DanielRam62/Smart-Water-Dispenser-Project/hardware_implementation/pcb_design/pcb_design 2.png

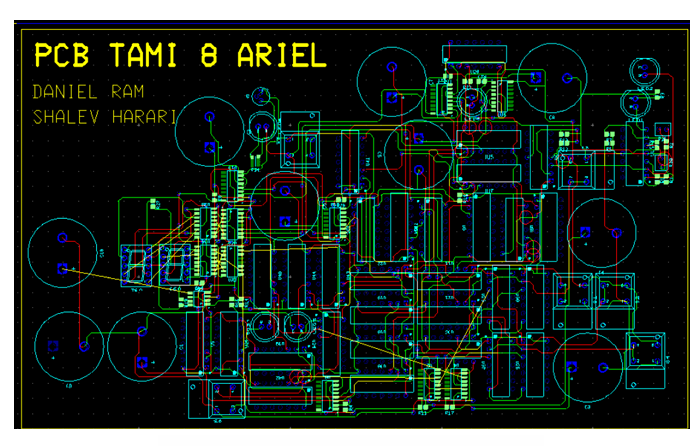
hardware_implementation/pcb_design/pcb_design 2.png
