DanielRam62/Smart-Water-Dispenser-Project/docs/project_summary.pdf

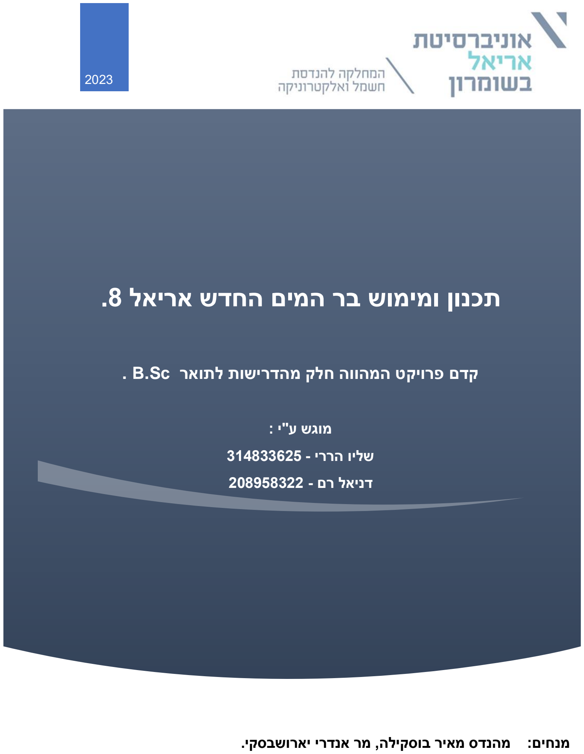
[picture p24: page 1]

# תכנון ומימוש בר המים החדש אריאל .8

קדם פרויקט המהווה חלק מהדרישות לתואר Sc.B .

### מוגש ע"י :

### שליו הררי - 314833625

### דניאל רם - 208958322

2023

מנחים: מהנדס מאיר בוסקילה, מר אנדרי יארושבסקי.

## תוכן העניינים:

.1.1 התפתחות ההיגיינה בעולם המודרני 4 |
.1.2 שילוב מערכות חכמות בהגיינה 5 |
.1.3 הצורך 5 |
.2 מטרת הפרויקט 6 |
.2.1 תנאי התכנון 6 |
.2.2 דרישות המערכת 7 |
.3 תיאור המערכת 8 |
.3.1 סכמת בלוקים 8 |
.4 תיכנון ומימוש חומרתי 11 |
.4.1 מימוש החומרה 11 |
.4.2 תיכנון החומרה | 11..
.5 מימוש המערכת 13 |
.5.1 סימולציות ותצוגות סקופ 13 |
.5.2 מימוש החומרה ע"י מיקרו בקר )ארדואינו(. 31 |
.5.3 PCB של המערכת | 32.
.6 תוצאות ואתגרים33 |

## הכרת תודה

לאורך הפרויקט היו מספר גורמים ואנשים אשר סייעו הן במחשבה הן בדיבור והן במעשה להצלחת הפרויקט.

על כן ברצוננו להודות ראשית לבורא עולם אשר מלווה אותנו בחיים בכלל ובמהלך הלימודים בפרט.

בנוסף תודה מיוחדת למשפחתנו האהובה אשר כל זה לא היה מתאפשר בלעדיה אשר מלווים אותנו לאורך לימודי התואר ותומכים בנו לכל אשר נפנה.

כמו כן , תודה אישית למנחים, מאיר בוסקילה ואנדריי יארושבסקי על הליווי במהלך הפרויקט.

## תקציר:

בפרויקט זה תוכננה ומומש ה מערכת חכמה לבקרה ושליטה על בר מים חכם.

לשם כך, ראשית נלמדו ונותחו הדרישות והפרמטרים בהם המערכת צריכה לעמוד.

מתוך כך תוכננה סכמת בלוקים ראשונית אשר באמצעותה תוכננה המערכת ברמת החיבורים והרכיבים .

קיימת דרישה של שליטה ובקרה על מספר פרמטרים: טמפרטורת מים, זמני מזיגה, עצירת מזיגה, הרתחה, איתות גלישת מים, הצגת טמפרטורת מים בזמן אמת והצגת זמני המזיגה )ספירה לאחור(. כחלק מדרישות אלו יש צורך לממש זאת במעגלים דיסקרטיים בלבד.

בכדי להעריך את טמפרטורת המים על פרמטר נעשה שימוש בחיישן מתאים להערכת הפרמטר וביצוע מניפולציות על נתון זה בכדי לקיים את כלל הדרישות.

לאחר תכנון סכמת בלוקים בוצע תכנון החומרה אשר נעשה בתכנון רכיבים וחיבורים בתוכנת סימולציה Multisim ובוצעו סימולציות לתקינות המעגל.

לאחר מכן, בוצע מימוש על גבי מטריצת חיבורים ובוצעו בדיקות תקינות המעגלים. בנוסף, נעשה תכנון PCB המוכן להדפסה עבור מעגלים אלו.

לאחר מכן, לטובת הצגת טמפרטורת מים בזמן אמת נעשה שימוש במיקרו בקר ) ארדואינו( אשר בעזרתו המערכת תוכל להציג למשתמש את טמפרטורת המים בזמן אמת .

במהלך כלל העבודה בפרויקט בוצעו תיעודיים למדידות ולקביעות שנעשו ובהתאם לכך בוצעו תיקונים לייעול המעגלים.

## 1( מבוא

עולם ההיגיינה הינו עולם בהתפתחות מתמדת.

התפתחות זו באה לידי ביטוי בטכנולוגיות שונות שמטרתם להפוך את אורך חיינו לבריא יותר .

בבר המים אריאל 8 בפרט קיימו ת דרישות רבות לייעול ובקרה על איכות המים. טמפרטורה, זמן מזיגה, קירור והרתחה ובנוסף אבטחה על המתקן .

השתלבות עולם ההנדסה בהתפתחות זו בא לידי ביטוי ביצור מערכות בקרה ושליטה על כלל הפרמטרים הנדרשים.

1.1 התפתחות ההיגיינה בעולם המודרני.

משחר ההיסטוריה היו מספר בעיות אשר גרמו לפגיעה בקדמה ש ל המין האנושי, כאשר השתיים המרכזיות הינן: חוסר היגיינה ואי קרבה למים זורמים.

מתחילת צעדיו של המין האנושי על פני כוכב לכת זה יכולנו לשים לב כי הדבר החיוני ביותר להתיישבות הינו מים זורמים ונקיים, אנו יכולים להבחין כי רוב אם לא כלל הערים העתיקות נבנו על יד מקורות מים נקיים אשר שימשו אותם בתחילה לשתייה ולחקלאות ובהמשך להפקת אנרגיה.

דבר נוסף אשר מאוד השפיע על המין האנושי היה חוסר בהיגיינה, נוכל לשים לב כי במהלך ההיסטוריה היו לא מעט מגפות, לדוגמא מגפת המוות השחור אשר הכתה באירופה במהלך המאה ה14 אשר קיפחו את חייהם של לא מעט אנשים, דבר אשר השפיע מאוד על הקדמה של המין האנושי.

עם התפתחות הטכנולוגיה והכרה במושג שנקרא היגיינה הומצאו פתרונות אשר בעזרתם המין האנושי יוכל להגדיל את תוחלת חייו ובנוסף להתגבר על מגפות אשר פוקדות את כוכב לכת זה, לדוגמא הקורונה, בעזרת שימוש רחב במוצרי היגיינה הצליח המין האנושי להתגבר על מג פה זו.

עם ההתפתחות, הטכנולוגיה שולבה גם בעולם ההיגיינה ובכך קידמה את האפשרות לתת למין האנושי אפשרות להתיישבות גם באזורים בהם לא ניתן להתקיים ממי השתייה )עקב זיהום נהרות ( ע"י פיתוח מוצר בר מים.

פיתוחים אלו הביאו לעלייה בתוחלת החיים ומתן נגישות של מים נקיים ליותר אוכלוסיות.

1.2 שילוב מערכות חכמות בהיג יינה.

עם התפתחות של העולם המודרני המערכת החיסונית של האדם נחלשה, אם בעבר אדם היה מצליח לחיות עד גיל מסוים ללא שימוש בחיסונים ובגישה מוגבלת למים נקיים בימינו דבר זה אינו אפשרי, כתוצאה מכך נדרש האדם לתת מענה לבעיה מספר אחת של האנושות, מקור מים זורמים ונקיים.

לשם כך נתכנסו כלל המהנדסים באוניברסיטת אריאל והבינו כי יש צורך למתן מכשיר ביתי אשר בעזרתו נקבל גישה למים נקיים ובנוסף אפשרות למתן מים רותחים וקרים אשר משמשים אותנו בצרכי היומיום. לשם כך קיימות מערכות טכנולוגיות לשליטה ובקרה על טמפרטורת המים. זמן מזיגה, זליגת מים מהכוס, מתן אפשרות להפסקת מזיגה ועוד.

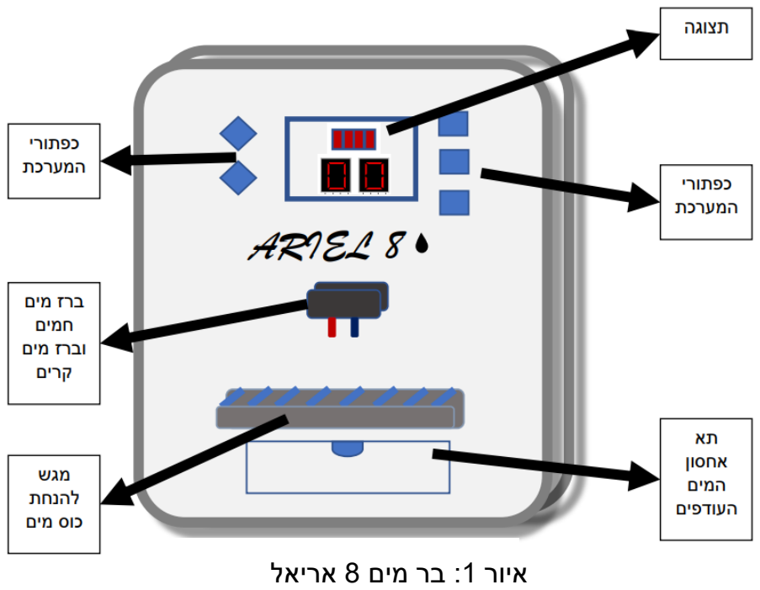
[picture p25: figure]

### 1.3 הצורך

עולם ההיגיינה מתפתח בצעדי ענק ומביא למהפכה בתחום, אך הבעיה העיקרית שהוא נלחם נגדה כיום הוא שינוי ההרגל של האדם הממוצע, בימנו לא מעט אנשים אינם שותים מספיק מים במהלך היום )במיוחד בימי החורף(, אחת מהדרכים להתמודד עם בעיה זו היא העלאת המודעות לחשיבות של צריכת מים נקיים ובנוסף לצריכת מים בכללי במהלך היום.

לשם כך הומצא בר מים זה אשר בעזרת לחיצת כפתור נותן גישה למקור מים נקיים ומרעננים בקלות ובמהירות.

איור :1 בר מים 8 אריאל | איור :1 בר מים 8 אריאל

## 2( מטרת הפרויקט

פיתוח מערכת אשר בעזרתה ניתן לתת הנגשה למים ראויים לשתייה לכל אחד מהבתים בישראל, מערכת זו נותנת אפשרות למשתמש לבחור את סוג המים )חמים , קרים ופושרים(, את זמן המזיגה של המים ) es ,4 es 8 ו es 15 ( ובנוסף מאותת למשתמש על מצב זליגה של מים מכלי המילוי.

2.1 תנאי התכנון.

בר המים שתוכנן במסגרת הקורס יכלול:

.1 בקר השולט על טמפרטורת המים 90° − .50° .2 בקר שני השולט על טמפרטורת המים 10° − .5° .3 כפתור הרתחה ל- .90°
.4 אפשרויות זמני מזיגה שונות. .5 מד טמפרטורה המציג את טמפרטורת המים בזמן אמת. .6 אפשרות הפסקת מזיגה בכל רגע נתון. .7 מתן איתות למשתמש כאשר מתבצעת זליגת מים מהכוס. .8 ספירה לאחור בעת מזיגת המים.

2.2 דרישות המערכת.

.1 בחירת סוג מים - על המערכת לתת למשתמש אפשרות לבחור את סוג המים בו הוא חפץ, חמים קרים או פושרים.

.2 הטמפרטורה שהבקר שולט עליה מתחלקת לשני חלקים. 2.1 -מים חמים- על הבקר לשמור על טווח טמפרטורת המים בין 90° − .50° 2.2 -מים קרים- על הבקר לשמור על טווח טמפרטורת המים בין 10° − .5°

.3 מספר אפשרויות המזיגה מתחלקת לשלושה חלקים: 3.1 : מים חמים - על המערכת לתת אפשרות מזיגת מים בתנאי והטמפרטורה של המים החמים מעל 90° למשך es .4 3.2 : מים קרים - על המערכת לתת אפשרות מזיגת מים כאשר זמני המזיגה הם כדלקמן : es ,4 es 8 ו es .15 בטווח טמפרטורה של 10° − .5° :3.3 מים פושרים - על המערכת לתת אפשרות מזיגת מים בטווח הטמפרטורה של 35° − 25° למשך es .4

.4 הרתחה- למשתמש ישנה אפשרות להרתיח את המים עד לטמפרטורה של .90°

.5 מד טמפרטורה- לכל אורך זמן המזיגה על המערכת להציג למשתמש את טמפרטורת המים ואת זמן המזיגה הנותר לסיום מילוי הכוס.

.6 אפשרות הפסקת מזיגה- על המער כת לתת אפשרות למשתמש לבצע הפסקת מזיגה בכל רגע נתון ע"י לחיצה על אחד מלחצני המערכת.

.7 מתן איתות- על המערכת לאותת למשתמש כי מתחילה זליגה של מים מ תא אחסון המים.

.8 ספירה לאחור – על המערכת להציג את זמן מזיגת המים שנותר בשעת מזיגה .

3( תיאור המערכת.

3.1 הסבר כללי על המערכת - סכמת בלוקים.

.1 שליטה על הטמפרטורה.

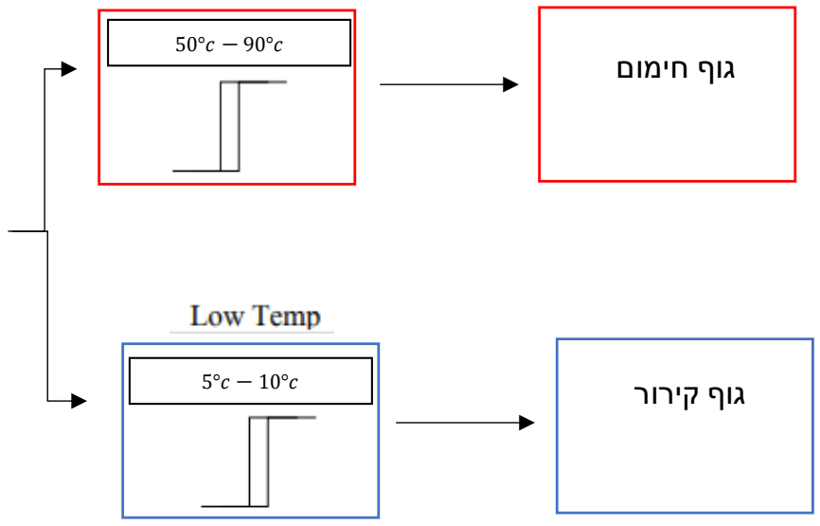
[picture p26: figure]
גוף חימום; גוף קירור

.2 מצב הרתחת מים.

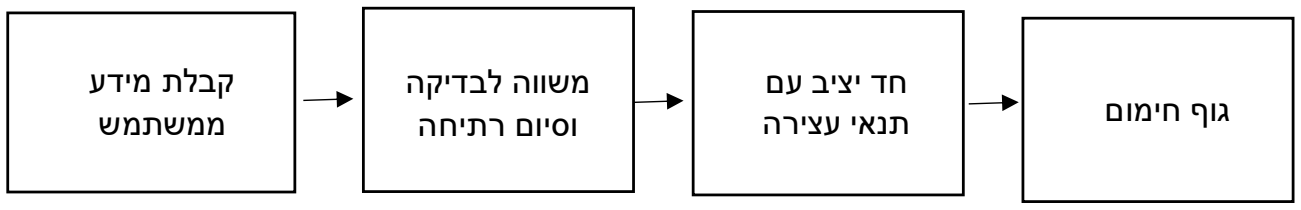
[picture p27: figure]
משווה לבדיקה וסיום רתיחה; קבלת מידע ממשתמש; חד יציב עם גוף חימום תנאי עצירה

.3 מצב מזיגת מים חמים

חיישן
טמפרטורה

איור :2 סכמת בלוקים לשליטה על טמפרטורה.

איור :3 סכמת בלוקים להרתחה המים

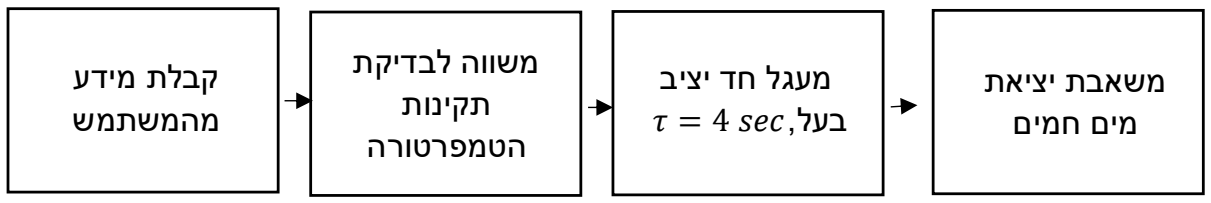
[picture p28: figure]
משווה לבדיקת תקינות הטמפרטורה; קבלת מידע מהמשתמש; מעגל חד יציב בעל,es 4 = ; משאבת יציאת מים חמים

איור :4 סכמת בלוקים למזיגת מים חמים.

4 . מצב מזיגת מים קרים.

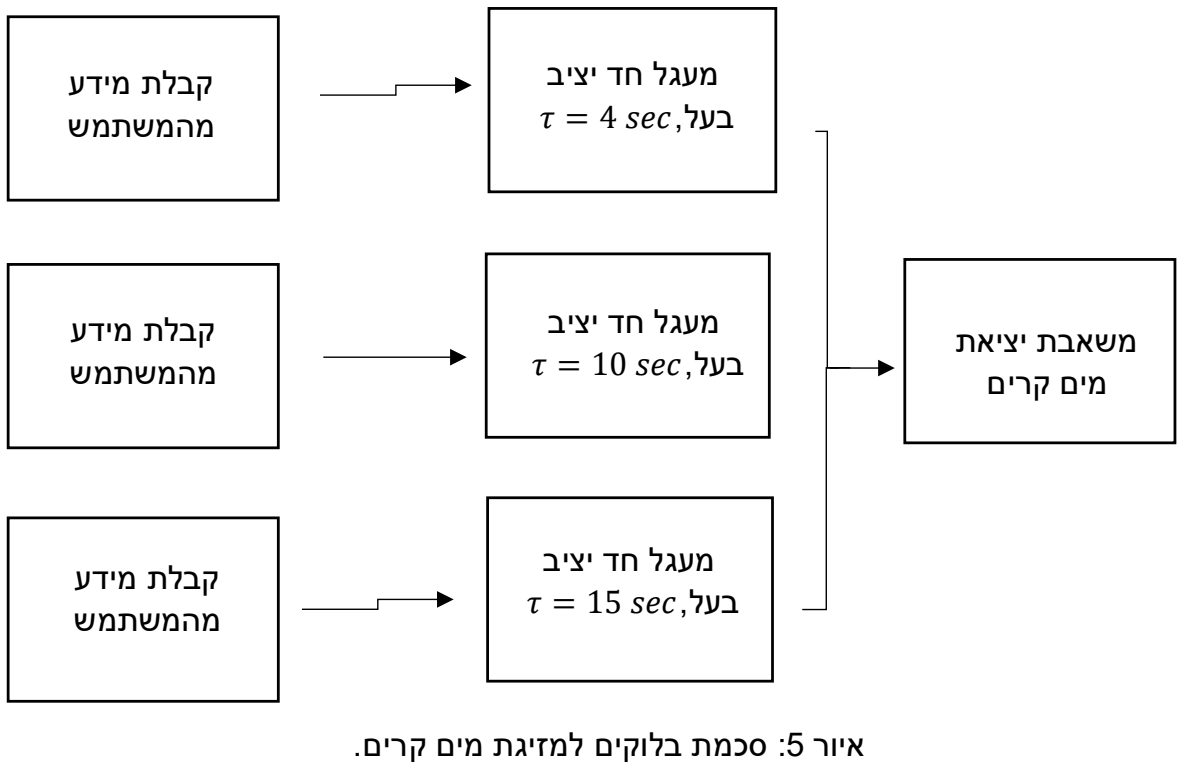
[picture p29: figure]
קבלת מידע מהמשתמש; מעגל חד יציב בעל,es 4 = ; מעגל חד יציב בעל,es 10 = ; מעגל חד יציב בעל,es 15 = ; משאבת יציאת מים קרים; איור :5 סכמת בלוקים למזיגת מים קרים.

5 . מצב מזיגת מים פושרים.

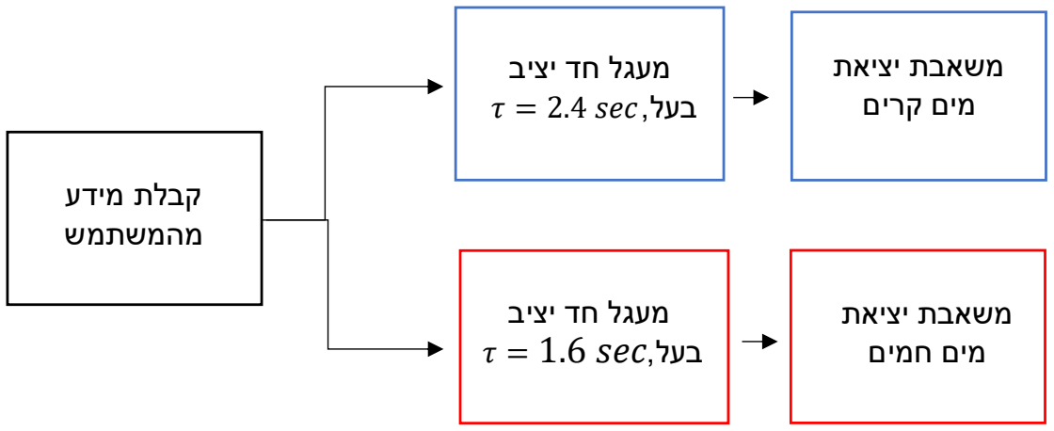
[picture p30: figure]
קבלת מידע מהמשתמש; משאבת יציאת מים קרים; משאבת יציאת מים חמים; מעגל חד יציב בעל,es 2.4 = ; מעגל חד יציב בעל,es 1.6 = 

איור :6 סכמת בלוקים למזיגת מים פושרים.

6 . צג ספירה לאחור

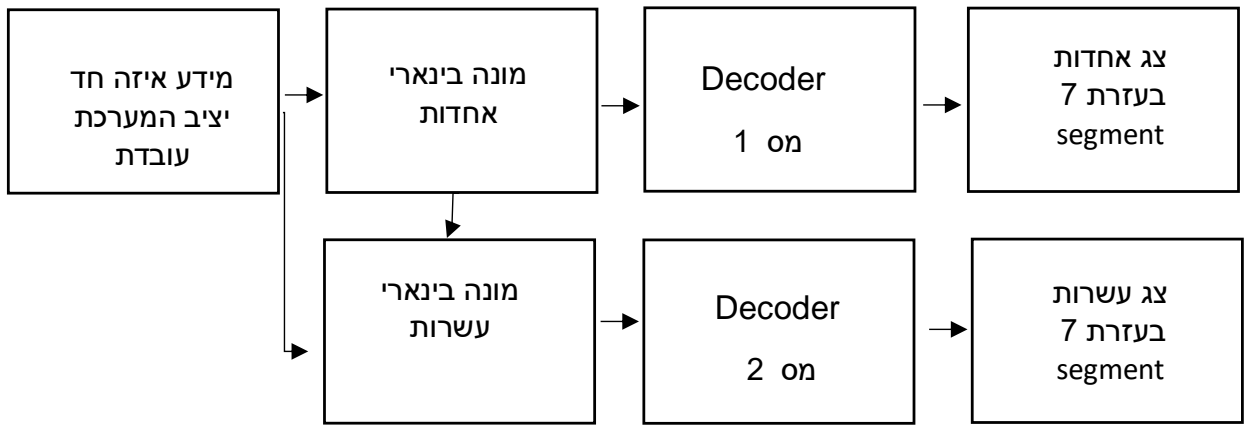
[picture p31: figure]
מידע איזה חד יציב המערכת עובדת; מונה בינארי אחדות; מונה בינארי עשרות; Decoder; צג אחדות בעזרת 7 segment; צג עשרות בעזרת 7 segment

7 . עצירת מערכת בעת לחיצה בזמן מזיגה .

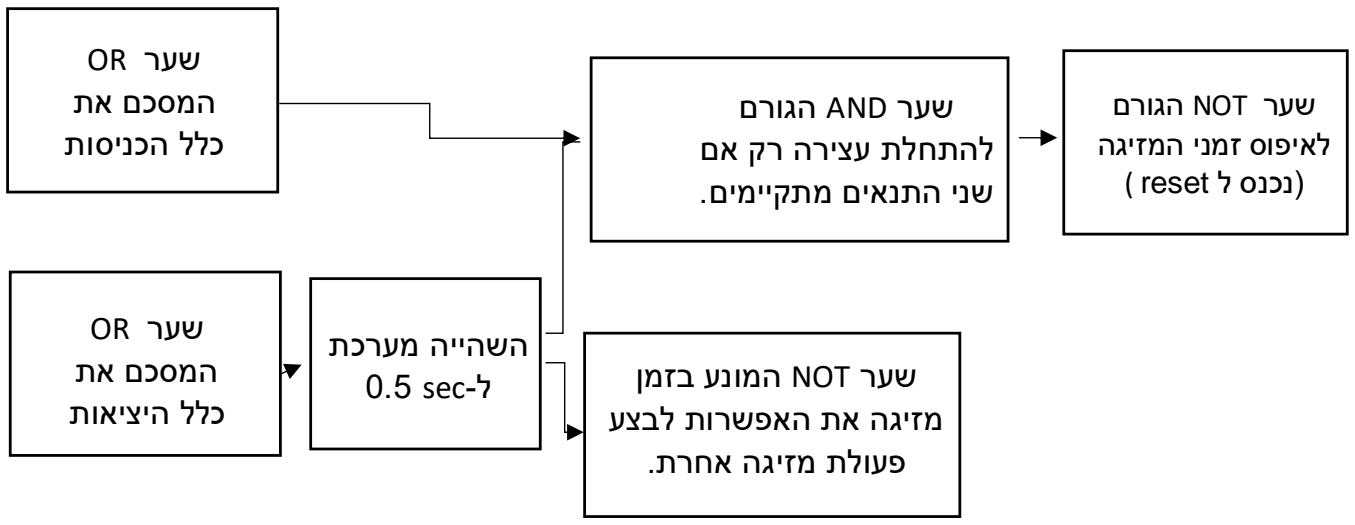
[picture p32: figure]
שער OR המסכם את כלל הכניסות; שער AND הגורם להתחלת עצירה רק אם שני התנאים מתקיימים.; שער OR המסכם את כלל היציאות; שער NOT הגורם לאיפוס זמני המזיגה )נכנס ל reset(; שער NOT המונע בזמן מזיגה את האפשרות לבצע פעולת מזיגה אחרת.; השהייה מערכת ל-sec 0.5

8 . נורת אזהרה.

איור :7 סכמת בלוקים להצגת ספירה לאחור.

איור :8 סכמת בלוקים להצגת עצירת מערכת.

חוט חשוף המחובר
לסף המים

חוט חשוף המחובר
ל-VCC

טרנזיסטור BJT
משמש בתור
מתג.

LED אינדיקציה,
המאותת
למשתמש

איור :9 סכמת בלוקים לנורת אזהרה.

4( תיכנון ומימוש חומרתי.

4.1 מימוש החומרה.

אופן המימוש בוצע על גבי מטריצת חיבורים אשר עליה נבנו כלל המעגלים על ידי הרכיבים הבאים

.1 מימוש בקר מים קרים , רכיבים - נגדים, מגבר )071TL(, חיישן טמפרטורה.
.2 מימוש בקר מים חמים, רכיבים- נגדים, מגבר (071TL( (מימוש שמידט טריגר(, חיישן טמפרטורה.
.3 כפתור הרתחת מים חמים, רכיבים- נגדים, קבלים, מעגל חד יציב )14538CD),
.)AND, OR, NOT( | לוגים | שערים | ,(TL071( | מגבר
.4 כפתור לחיצה המאפשר מזיגת מים חמים, רכיבים- נגדים, קבלים, מעגל חד יציב
.(AND,OR( | לוגים | שערים | ,(MC14538(
.5 כפתור לחיצה המאפשר מזיגת מים קרים ע"פ בחירת משתמש, רכיבים - נגדים, קבלים, חד יציב ) 14538MC )שערים לוגים )OR,AND(. .6 כפתור לחיצה המאפשר מזיגת מים פושרים, רכיבים- נגדים, קבלים, חד יציב )14538MC), שער לוגי Or.
.7 ספירה לאחור, רכיבים – segment seven, Decoder) D47LS74 (, נגדים, שערים
.)74LS190D( | בינארי | מונה | ,(Or And ( | לוגים
.8 מד טמפרטורה, רכיבים – מיקרו בקר )ארדואינו(, חיישן טמפרטורה.

כמו כן המטריצה הוזנה לאספקת מתח קבוע של V5 להספקת כלל הרכיבים במעגל.

4.2 תכנון החומרה.

טמפרטורה – חיישן הטמפרטורה הינו נגד משתנה כתלות בטמפרטורה. עבור תחומי הטמפרטורה הרצויים הובאו ערכי התנגדות החיישן מתוך דפי הנתונים כדלהלן :

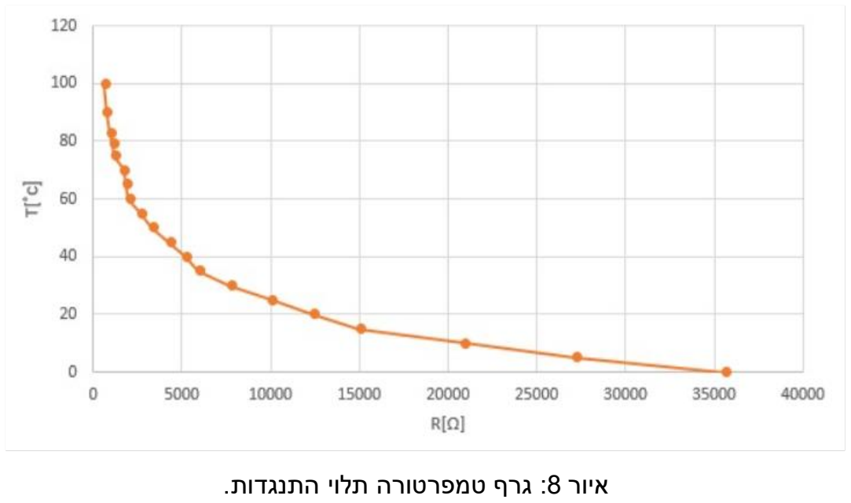
[picture p33: figure]
Ϲ מעלות; התנגדות )Ω); גרף התנגדות חיישן טמפרטורה; איור :8 גרף טמפרטורה תלוי התנגדות.

באיור 8 נוכל להבחין בגרף המתאר את טמפרטורת החיישן כתלות בהתנגדות, בעזרת גרף זה ניתן לחשב את יחס הנגדים הנדרש בכדי לאותת למערכת כי טמפרטורת המים תקינה.

טבלה 1 – ערכי התנגדות החיישן ומתח בטמפרטורות נצרכות

| | טמפרטורה ]˚C ]התנגדות ]kΩ ]מתח מוצא חיישן ]V ]
1.62 | 20.8 | 10
3.75 | 3.3 | 50
4.66 | 0.725 | 90

בתחילה חובר החיישן טמפרטורה לרב מודד כאשר בכל פעם הועלתה הטמפרטורה ונמדדה התנגדותו, לאחר מכן נעשה חישוב הבא בעזרת נוסחת מחלק מתח:

(1) Vout,sensor = VCC ∗

10k

10k + Rsensor

[V]

ובכך התקבל כי לכל התנגדות מתקבל מתח מוצא שונה אשר בעזרתו נוכל להבין מתי בקר הרתחה אמור להתחיל ולסיים את עבודתו , וכמו כן האם מזיגת מים חמים יכולה להתאפשר.

מים פושרים- על המערכת לתת אפשרות מזיגת מים בטווח הטמפרטורה של 35° − 25° למשך es .4 לשם כך תוכנן יחס המים על ידי ניסוי וטעייה, ונמצא:

טבלה 2 – תיכנון מזיגת המים הפושרים

אכן נמצא שיחס המים לעיל עומד בדרישות המערכת והוא נבחר כיחס הנגדים האחראים על זמן מזיגת המים הפושרים.

טמפרטורה סופית ]˚c[ | יחס מים של מזיגת המים | טמפרטורה חמים ]˚c[ | טמפרטורה קרים ]˚c[
27 | 3/5 | 51 | 7
34 | 2/5 | 85 | 7

5( מימוש המערכת.

5.1 סימולציות ותצוגות סקופ.

.1 תכנון מפורט ברמת החיבורים של בלוק טמפרטורה עבור מים קרים.

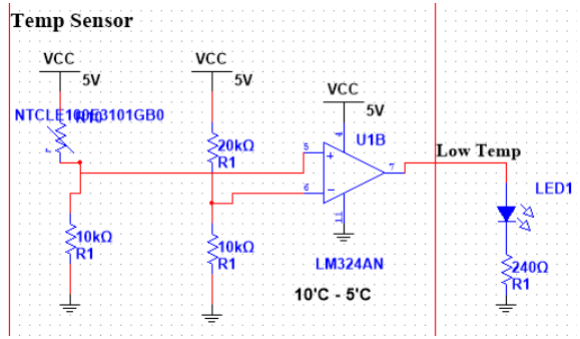
[picture p34: figure]

סנסור הטמפרטורה הינו נגד משתנה כפונקציה של הטמפרטורה והוא מזין את רגל החיובית של המגבר .

באיור מספר 9 ניתן להבחין במגבר משווה, אשר תפקידו לייצר מעגל חשל טמפרטורה עבור טמפרטורה נמוכה וזאת בעזרת השוואה בין המתחים כאשר המתח הנמצא ברגל המינוס של המגבר הוא קבוע )המסמן הגעה ל 10° ראה טבלה 1(.

תוכנן כך כאשר מתח רגל הפלוס של המגבר יותר גדול ממתח רגל המינוס של המגבר הלד יידלק )המסמן שהטמפרטורה גבוהה מ 10°) וכך יסמן למערכת לקרר את המים בחזרה למתחת ל.10°

בנוסף ניתן לשים לב כי במעגל זה יש LED אשר תפקידו לאותת למשתמש כי הבקר עובד, מתחיל תהליך קירור של המים.

איור :9 סימולציה עבור בקר מים קרים.

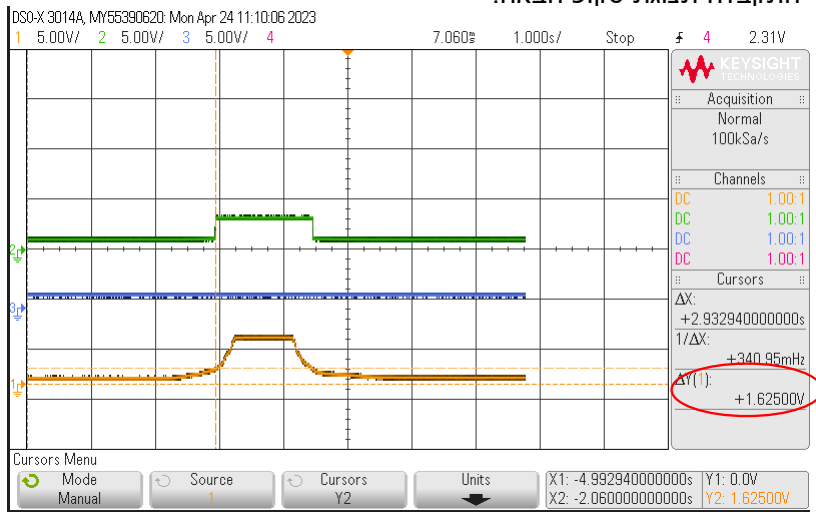
[picture p35: figure]

בהמשך התקבלה תצוגת סקופ הבאה:

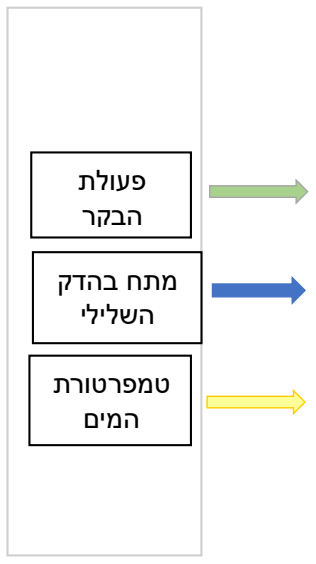
[picture p36: figure]
טמפרטורת המים; פעולת הבקר; מתח בהדק השלילי

תחילה הורכב המעגל באיור 9 )בקר מים קרים(, באיור 10 ניתן להבחין בשלושה ערוצים.

ניתן להבחין בשלושה דברים עיקריים :

הראשון - טמפרטורת החיישן )צהוב(, ניתן לשים לב כי כאשר הטמפרטורה גבוהה מ 10° המסמן הגעה של מתח של V1.625( הסבר בטבלה 1( מתקבל פולס )ירוק ( להתחלת קירור המים הקרים.

השני - פולס שהבקר מוציא להתחלת קירור המים, כפי שהוסבר בתחילה ניתן להבחין כי כל עוד מתח בהדק החיובי של המגבר המסמן את טמפרטורת המים גבוהה ממתח ההדק השלילי המסמן טמפרטורה של 10° מתחילה פעולת הבקר )ירוק( .

השלישי-מתח בהדק השלילי של המגבר המסמן הגעה לטמפרטורה של 10° )כחול (.

איור :10 סקופ בקרת מים קרים.

2 . תכנון מפורט ברמת החיבורים של בלוק טמפרטורה עבור מים חמים.

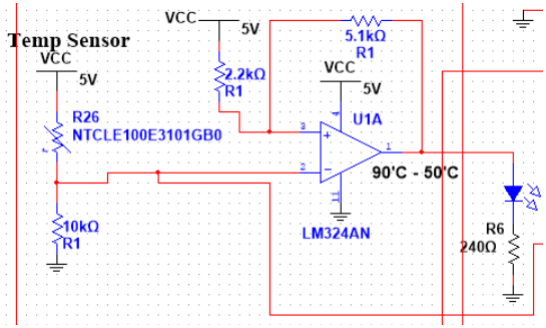
[picture p37: figure]

סנסור הטמפרטורה הינו נגד משתנה כפונקציה של הטמפרטורה והוא מזין את רגל השלילית של המגבר .

באיור מספר 11 ניתן להבחין במגבר הממומש בתצורה של "שמידט טריגר" אשר בעזרתו המערכת תוכל להבחין מתי הטמפרטורה יורדת מתחת ל 50° וכך תדליק את הלד המסמן למערכת להתחיל את תהליך הרתחה.

בנוסף ניתן לשים לב כי במעגל זה יש LED אשר תפקידו לאותת למשתמש כי הבקר עובד, מתחיל תהליך ההרתחה של המים.

איור :11 סימולציה עבור בקר מים חמים.

בהמשך התקבלה תצוגת סקופ הבאה:

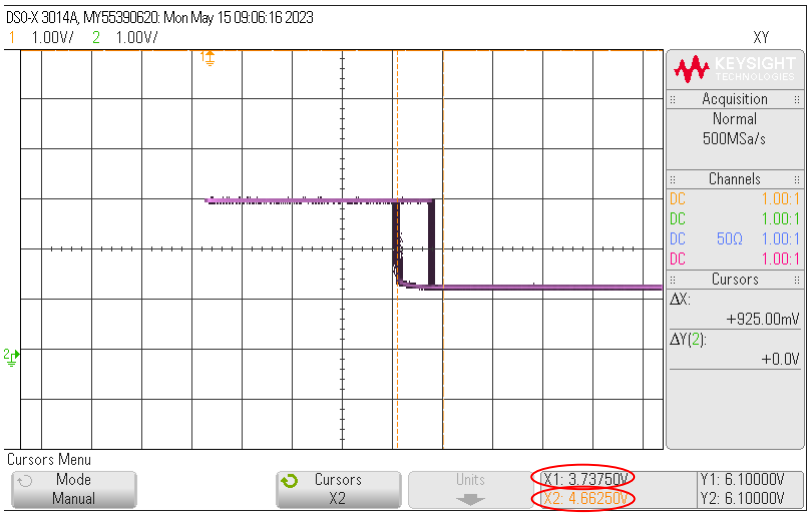
[picture p38: figure]

תחילה הורכב המעגל באיור 11 )בקר מים חמים(, באיור 12 ניתן להבחין בתצורת המעגל במישור XY.

בנוסף ניתן להבחין בשלושה דברים עיקריים:

הראשון - תצורת האות במישור XY, נוכל להבחין בתצוגה המזכירה עקומת חשל, כאשר ניתן לראות בברור מתי הבקר מתחיל לעבוד ומתי הינו בהפסקה.

השני - ערך ה "Cross של 2X", ניתן לשים לב כי ה Cross מצביע על מתח של V,4.66 כאשר מתח זה הינו מתח הסף המצביע על 90° )ראה טבלה 1(.

השלישי- ערך ה "Cross של 1X", ניתן לשים לב כי ה Cross מצביע על מתח של V,3.73 כאשר מתח זה הינו מתח הסף המצביע על 50° )ראה טבלה 1(.

ניתן לראות כי אכן נשמרת טווח הטמפרטורה הרצוי.

איור :12 סקופ בקרת מים חמים.

.3 תכנון מפורט ברמת החיבורים של בלוק ההרתחה.


באיור מס 13 ניתן להבחין במספר רכיבים אשר תפקידם לבצע את פעולת הרתיחה. הראשון מגבר – תפקידו לבדוק האם הטמפרטורה נמצאת מתחת ל- 90° וכך לבצע הרתחה של המים ובנוסף להפסיק את פעולת ההרתחה כאשר טמפרטורת המים מגיעה ל-.90°c

השני שעון- השעון עצמו לא נמצא בסימולציה אך תפקידו נראה בברור, שעון זה אחראי על איתות הנורה, כאשר אות השעון נכנס לשער AND עם הפולס שיוצא מהחד יציב מתקבל מצב של הבהוב אשר מאותת למשתמש כי המערכת נמצאת במצב הרתחה.

השלישי מעגל חד יציב- תפקידו של רכיב זה הוא להפעיל את בקר ההרתחה כאשר הנחה היא שתוך sec20 המערכת "מצליחה" להרתיח את המים לטמפרטורה של .90°

איור :13 סימולציה עבור הרתחת המים החמים.

בהמשך התקבלה תצוגת סקופ הבאה:

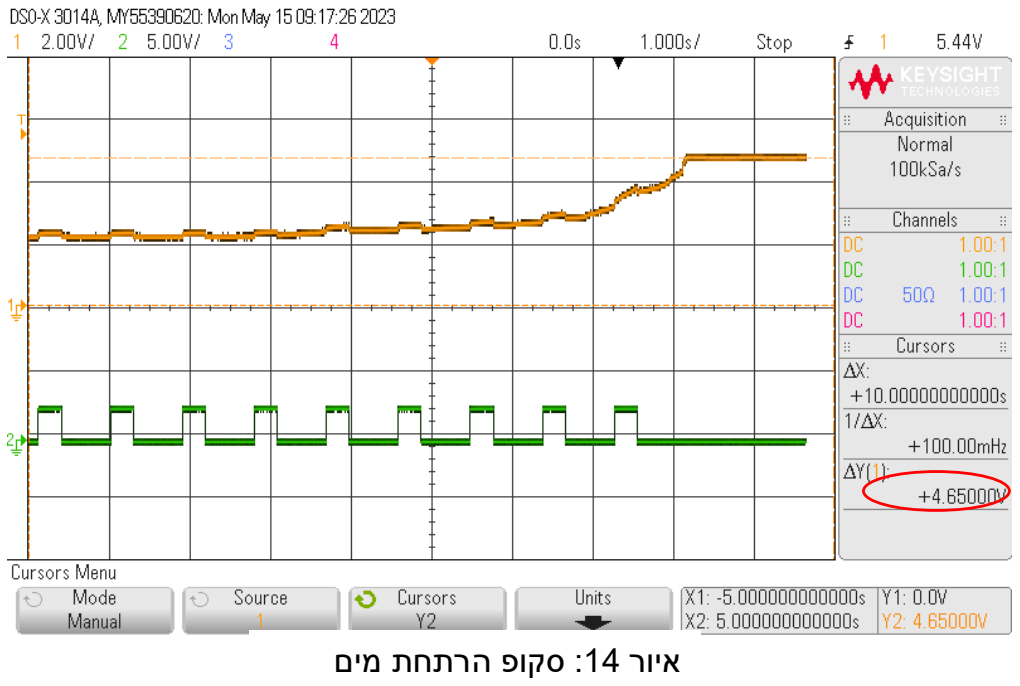
[picture p39: figure]
איור :14 סקופ הרתחת מים

באיור מספר 14 נוכל להבחין בשני ערוצים:

הראשון )צהוב( מראה את פעולת הבקר, השני )ירוק( מראה את הבהוב הנורה.

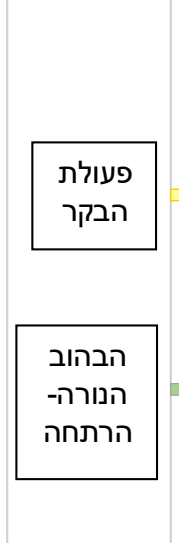
[picture p40: figure]
פעולת הבקר; הבהוב הנורה- הרתחה

נוכל לשים לב כי בתחילה מתקבל גל ריבועי המסמן את פעולת ההבהוב של הלד)ירוק(, ככל שטמפרטורת המים עולה כך יורדת ההתנגדות של החיישן, וכתוצאה מכך עולה המתח של הבקר עד אשר הוא מגיע למתח של V4.65 המסמן הגעה ל 90° )צהוב(, כאשר הבקר מגיע לטמפרטורה זו ניתן להבחין בהפסקת הפולסים המסמן כי ברגע זה נגמרת פעולת ההבהוב של הנורה המאותת למשתמש כי המים ראויים לשימוש.

.4 תכנון מפורט ברמת החיבורים של מזיגת מים חמים.

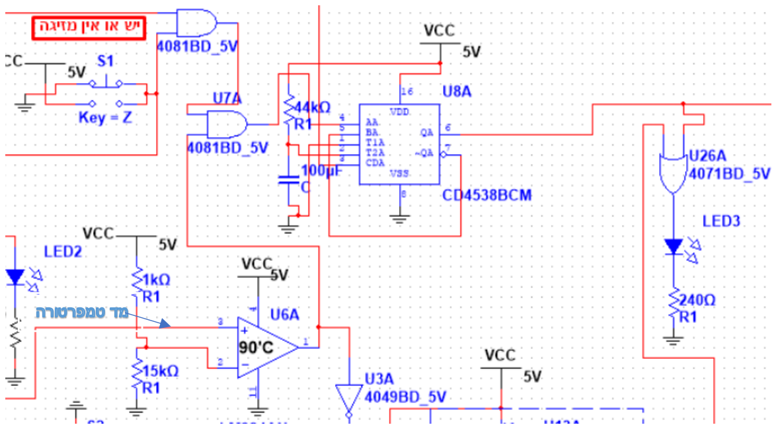
[picture p41: figure]

באיור מס 15 נוכל להבחין במספר רכיבים שבעזרתם נוכל לבצע את פעולת המזיגה כראוי.

הראשון מתג – תפקידו לתת למערכת אינדיקציה כי המשתמש מעוניין להתחיל את תהליך המזיגה.

השני מגבר- תפקידו לתת אינדיקציה למערכת האם טמפרטורת המים מעל ל,90°

האות מהמגבר וגם האות מהמשתמש נכנסים לתוך שער AND אשר תפקידו לתת אינדיקציה כי שני התנאים למזיגה מתקיימים וכך מתחילת פעולת המזיגה.

השלישי מעגל חד יציב – תפקידו של רכיב זה הוא לבצע את פעולת זמן המזיגה, זמן המזיגה מומש בעזרת הנוסחה הבאה:

(2) τ = RC[sec]

לשם כך נבחרו הקבל והנגד הנ"ל למימוש הדרישה.

איור :15 סימולציה עבור מזיגת מים חמים.

בהמשך התקבלה תצוגת סקופ הבאה:

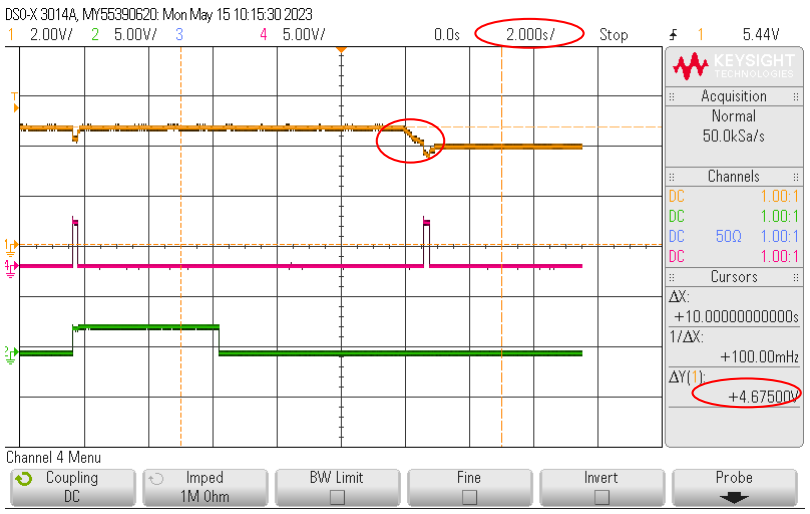
[picture p42: figure]

באיור מספר 16 נוכל להבחין בשלושה ערוצים:

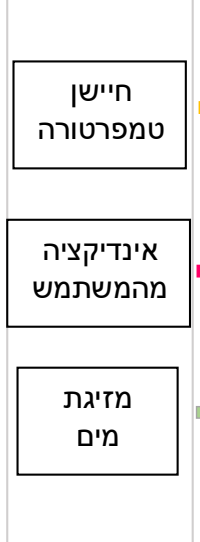
[picture p43: figure]
חיישן טמפרטורה; אינדיקציה מהמשתמש; מזיגת מים

הראשון )כתום( מראה את טמפרטורה המים , השני )ורוד( מראה את המידע שהמשתמש מזין למערכת, השלישי ) ירוק( מראה את מזיגת המים החמים.

בערוץ הראשון )כתום( – ניתן להשים לב למתח, ככל שטמפרטורת המים עולה ישנה ירידה בהתנגדות של החיישן, כתוצאה מכך עולה המתח של החיישן. במקרה הנ"ל מתח החיישן מתחיל מעל לV4.65 המסמן טמפרטורה מעל 90° ולאחר זמן מתח החיישן יורד מתחת לV4.65 המסמן ירידה של טמפרטורה למתחת ל- .90°

בערוץ השני )ורוד ( – נוכל להבחין בשני "הלמים", הלמים אלו נוצרים מבחירתו של משתמש )מתקבלת לחיצה על המתג(. ישנם שני הלמים בתצוגה זו, כאשר הראשון מצליח לגרום לפעולת מזיגה בעוד השני אינו מצליח, הבדל זה נובע מכך שטמפרטורת המים מתחת למתח של V,4.65 בעוד שניתן להבחין כי במקרה הראשון מתח החיישן מעל ל V4.65 המסמן שטמפרטורת המים מעל 90° כתוצאה מכך נשים לב כי לא התחילה פעולת מזיגה בשנית עקב שינוי בטמפרטורה.

בערוץ השלישי )ירוק( – נוכל להבחין בפעולת המזיגה, נוכל לשים לב שכל ריבוע בתצוגה מייצג es 2 וכי רוחבו של הפולס המתקבל הוא לערך שני ריבועים דבר המצביע על תקינות זמן המזיגה.

איור :16 סקופ מזיגת מים חמים.

5 . תכנון מפורט ברמת החיבורים של בלוק מזיגת מים קרים.


באיור מספר 17 נוכל להבחין במספר רכיבים אשר בעזרתם נוכל לבצע את פעולת המזיגה.

הראשון מתגים- תפקידים של מתגים אלו הוא לתת אינדיקציה למערכת להתחיל את פעולת המזיגה אשר המשתמש חפץ.

השני מעגלי חד יציב – בסימולציה זו ישנם שלושה מעגלים אך תפקידם זהה, תפקידו של כל מעגל הינו לשלוח פולס לאורך זמן מסוים בכדי לבצע את פעולת המזיגה, ערכי הקבלים

איור :17 מעגל עבור מזיגת מים קרים.

והנגדים חושבו ע"פ משוואה 2 כאשר בכל פעם נדרש מהמערכת להוציא פולס באורך זמן אחר , כאשר הזמנים הינם es 4 ,es 8 ,es 15 בהתאמה.

בהמשך התקבלה תצוגת סקופ הבאה:

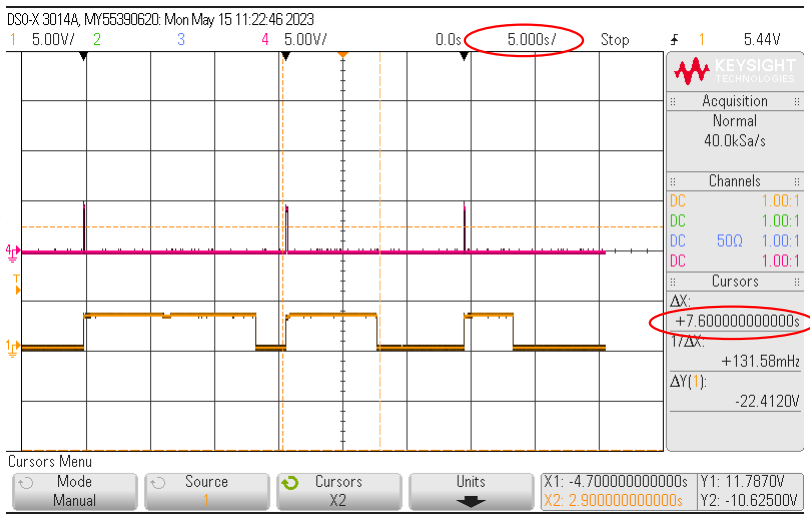
[picture p44: figure]

באיור מספר 18 נוכל להבחין בשני ערוצים:

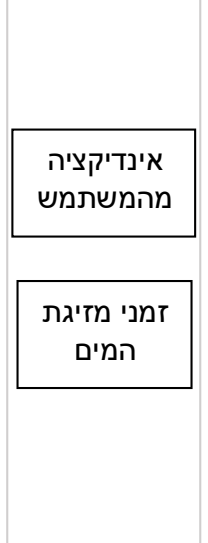
[picture p45: figure]
אינדיקציה מהמשתמש; זמני מזיגת המים

הראשון )ורוד( מראה את המידע שהמשתמש מזין למערכת, השני )צהוב( מראה את זמן יציאת המים הקרים.

בערוץ הראשון )ורוד( – ניתן להבחין בשלושה "הלמים", הלמים אלו נוצרים מבחירתו של משתמש )מתקבלת לחיצה על המתג(. ישנם שלושה הלמים בתצוגה זו, כאשר כל אחד מהם מציג את תחילת פעולת המזיגה.

בערוץ השני )צהוב( – ניתן להבחין בפעולת המזיגה, נוכל לשים לב שרוחבו של כל ריבוע בתצוגה מייצג es .5 בכל פעם נוכל להבחין באורך פולס אחר, דבר זה נובע מהמידע שהמשתמש מזין למערכת, בתחילה ניתן להבחין באורך פולס המשתרע על בערך 3 משבצות אשר מייצג את זמן המזיגה שהינו es ,15 בהמשך ישנו פולס המשתרע על בערך משבצת וחצי אשר מייצג זמן המזיגה שהינו es ,8 לבסוף ישנו פולס המשתרע על כמעט משבצת אחת אשר מייצג זמן מזיגה שהינו es .4

איור :18 סקופ מזיגת מים קרים.

.6 תכנון מפורט ברמת החיבורים של בלוק מזיגת מים פושרים.

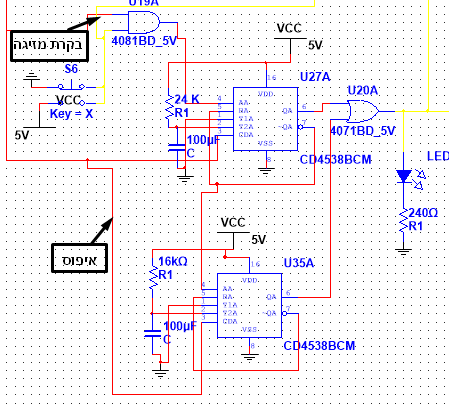
[picture p46: figure]

באיור מספר 19 ניתן להבחין במספר רכיבים אשר בעזרתם ניתן לבצע את פעולת המזיגה.

הראשון מתג – מתן אינדי קציה למערכת כי משתמש מעוניין במזיגת מים פושרים.

השני מעגלי חד יציב – תפקידם של שני מעגלים הוא להתחיל את תהליך המזיגה, כאשר המעגל החד יציב הראשון מחובר למשאבה של המים הקרים , והמעגל של החד יציב השני מחובר למשאבה של המים חמים.

ערכי הנגדים והקבלים חושבו ע"י שני התנאים הבאים:

1( ע"י נוסחה 2 כאשר זמן המזיגה הכולל הינו es 4 . 2( יחס מזיגת המים כבטבלה 2 והוא 2/5 מזיגת מים חמים ו 3/5 מזיגת מים קרים כך שיתקבל הדרישה לטמפרטורה מים פושרים.

כתוצאה מכך זמן המזיגה של המים החמים נבחר כ- es 1.6 וזמן מזיגת המים הפושרים נבחר כ-es .2.4

איור :19 מעגל עבור מזיגת מים פושרים.

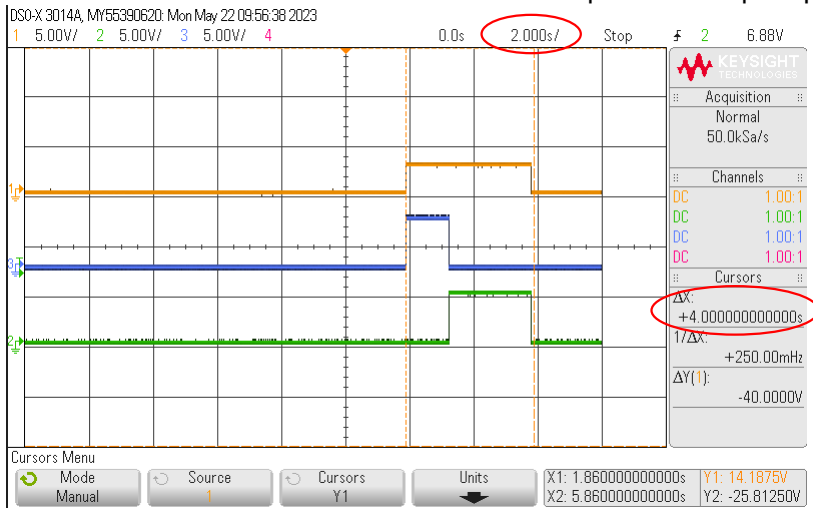
[picture p47: figure]

בהמשך התקבלה תצוגת סקופ הבאה:

באיור מספר 20 נוכל להבחין בשלושה ערוצים:

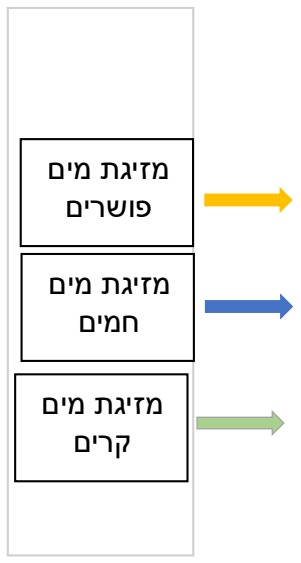
[picture p48: figure]
מזיגת מים פושרים; מזיגת מים חמים; מזיגת מים קרים

הראשון )צהוב( מראה את זמן המזיגה הכולל הנותן מים פושרים, השני )כחול( מראה את זמן יציאת המים החמים והשלישי )ירוק( מראה את זמן יציאת המים הקרים.

בערוץ הראשון )צהוב( – ניתן להבחין בפולס היציאה הכולל, זאת אומרת ניתן לשים לב לזמן הכולל של יציאת המים הפושרים, בנוסף ניתן להבחין בשני "קרוסים" המעידים על זמן מזיגה כולל של es 4 כפי שנדרש.

בערוץ השני )כחול( – ניתן להבחין בפעולת המזיגה של המים החמים, בנוסף ניתן להבחין באיור כי הזמן למשבצת הינו es 2 , הפולס הכחול הינו כמעט משבצת דבר המעיד על זמן מזיגה של מים חמים כ- es ,1.6 כפי שהיה ניתן לצפות.

בערוץ השלישי )ירוק( – ניתן להבחין בפעולת המזיגה של המים הקרים, בנוסף ניתן להבחין באיור כי הזמן למשבצת הינו es 2 , הפולס הירוק הינו משבצת וקצת דבר המעיד על זמן מזיגה של מים קרים כ- es ,2.4 כפי שהיה ניתן לצפות.

איור :20 סקופ מזיגת מים פושרים.

7 . תכנון מפורט ברמת החיבורים של עצירת מערכת.


באיור מספר 21 ניתן להבחין במספר רכיבים אשר בעזרתם ניתן לבצע את פעולת עצירת המערכת .

הראשון שערי OR - ניתן להבחין בשני שערי OR אשר לכל אחד מהם תפקיד שונה, הראשון – בזמן לחיצה, תפקידו של שער זה הוא לאגד את כלל הפולסים היוצאים מהמתגים בעת הלחיצה. השני – זמן מזיגה, תפקידו של שער זה הוא לאגד את כלל הפולסים היוצאים מכלל מעגלי החד יציב בזמן מזיגה.

השני שער AND - תפקידו של שער זה הינו לבצע בדיקה, בבדיקה זו השער יברר אם מתקבל מצב בו ישנו פולס מזיגה )מתבצעת מזיגת מים( ובנוסף ישנו פולס לחיצה )מתקבל מידע ממשתמש כי הוא מעוניין לעצור את מזיגת המים( אם ורק אם שני התנאים הללו מתקיימים שער זה יוציא " 1" לוגי.

השלישי שער )איפוס( NOT - תפקידו של שער זה הוא לבצע היפוך, כאשר יצא " 1" לוגי מהשער AND( זאת אומרת שני התנאים מתקיימים: מזיגה, מידע ממשתמש( נקבל היפוך של "1" לוגי כלומר נקבל "0" לוגי כאשר מוצא ה not מחובר לכלל הדקי ה-Reset וכתוצאה מכך יתחיל תהליך האיפוס בכל אחד מרכיבי החד יציב אשר גורם לעצירת הפולס )עצירת המערכת(.

הרביעי שער )בקרת מזיגה( NOT - תפקידו של שער זה לבצע היפוך כאשר יש תהליך מזיגה באחד מהחדי יציב. מוצא ה -not מחובר לכלל ה-and של כניסות החדי יציב בנוסף ללחיצה של המשתמש. כאשר יש מזיגה של המערכת ה-and מוציא "0" לוגי ולא התאפשר מזיגה נוספת בזמן מזיגה של משאבה אחרת וכך התאפשר עצירת מזיגה אך לא הותחל מזיגה.

איור :21 מעגל עבור עצירת מערכת.

החמישי השהיה בעזרת נגד וקבל - נצרך השהייה של ה-Or בזמן מזיגה כדי שהמערכת לא תוציא במוצא ה-and" 1 "לוגי באותו רגע של תחילת מזיגה ראשונה . נקבעה השהייה של .0.5 sec

בהמשך התקבלה תצוגת סקופ הבאה:

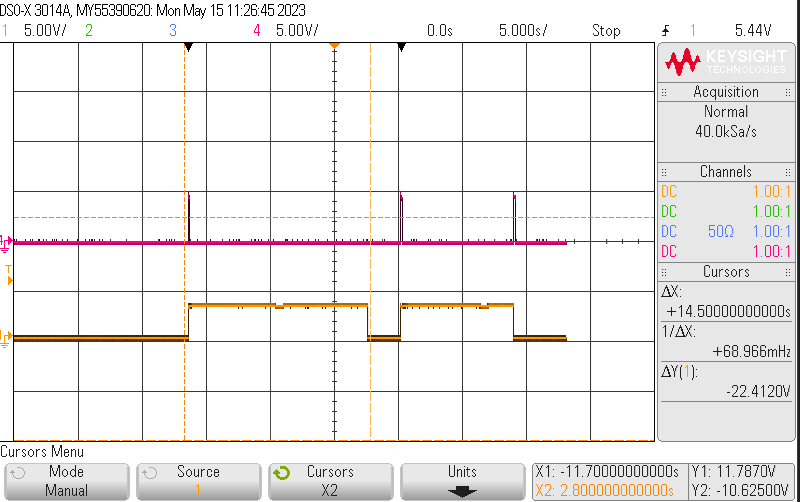
[picture p49: figure]

באיור מספר 22 ניתן להבחין בשני ערוצים:

הראשון )ורוד( מראה את המידע שהמשתמש מזין למערכת, השני )צהוב( מראה את זמן יציאת המים הקרים מזיגת המים במערכת.

בערוץ הראשון )ורוד( – ניתן להבחין בשלושה "הלמים", הלמים אלו נוצרים מבחירתו של משתמש )מתקבלת לחיצה על המתג(. ישנם שלושה הלמים בתצוגה זו, כאשר הראשון והשני מתחילים את פעולת המזיגה, בעוד השלישי מבצע עצירה כללית של המערכת.

בערוץ השני )צהוב( – ניתן להבחין בפעולת המזיגה, נוכל לשים לב שכל ריבוע בתצוגה מייצג es .5 תחילה נוכל לשים לב לפולס אשר מייצג את זמן המזיגה של הארוך ביותר )es 15( נוכל להבחין כי האות משתרע על שלוש משבצות לערך. בזמן הלחיצה השנייה

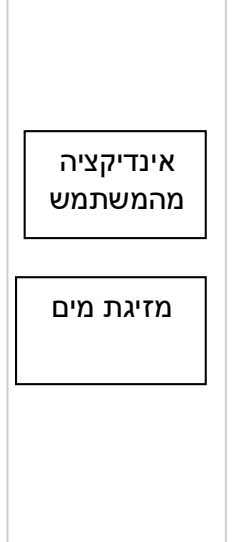
[picture p50: figure]
אינדיקציה מהמשתמש; מזיגת מים

)הלם מס 2( פעולה זו מתחילה בשנית )פולס יוצא של es 15( אך ההבדל העיקרי בין אות זה לבין זה שלפניו הוא שאות זה נקטע באמצע, קטיעה זו נוצרת כתוצאה מלחיצה חוזרת על אחד מלחצני המערכת )דבר הגורם לעצירה מוחלטת של המערכת( .

איור :22 סקופ עצירת מערכת.

8 . תכנון מפורט ברמת החיבורים של שעון המערכת.


באיור מספר 23 ניתן להבחין בזמזם 555 – אשר תפקידו הוא לייצר אות ריבועי עם זמן מחזור למשך שנייה, בעזרתו של שעון זה נוכל לסנכרן את המונה הספירה לאחור, לזמן של שנייה אחת. לשעון זה שימוש נוסף, בעזרתו ניתן להראות את ההבהוב אשר תפקידו להראות כי מתבצעת פעולת ההרתחה.

משוואת השעון:

(3) f =

1.44
(R1 + 2R2

) × C1

[Hz] =

1.44
(240 + 2 × 7k) × 100u

≅ 1Hz

איור :23 מעגל עבור שעון המערכת.

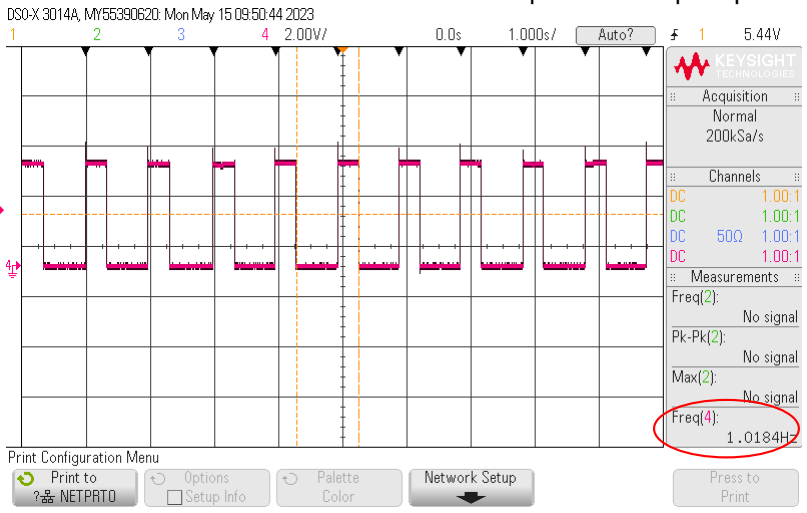
[picture p51: figure]

בהמשך התקבלה תצוגת סקופ הבאה:

באיור מספר 24 נוכל להבחין בתצוגת שעון המערכת:

בתצוגת סקופ זו נוכל להבחין בשעון המערכת, לשעון זה שימושים רבים כאשר הבולטים מבניהם יצירת סנכרון המונה הבינארי ויצירת הבהוב נורה ב עת ההרתחה, נוכל להבחין כי תדירות של אות זה הינה Hz,1.0184 דבר המעיד על כך שזמן מחזורו של השעון הינו .1 sec

(4) T =

1
f

[sec] =

1
1.0184

≈ 1 sec

שעון

איור :24 סקופ שעון המערכת.

9 . תכנון מפורט ברמת החיבורים של מונה סופר אחורה.


באיור מספר 25 ניתן להבחין במספר רכיבים אשר בעזרתם נוכל לבצע את פעולת הספירה לאחור.

הראשון שער AND – תפקידו של שער זה הינו לאפשר את המונה, זאת אומרת מתן אפשרות למונה להתחיל בספירה כאשר ההדקים שלו מחוברים לאפשור מזיגה.

השני מונה בינארי )BCD –)תפקידו של רכיב זה הוא למנות אחורה )מקבל בהדק d/u" 1 " לוגי כך שמתחיל מנייה לאחור(, רכיב זה מקבל מידע מהמשתמש )זמן מזיגה רצוי( ומהשעון )זמן מחזור של es 1( ומתחיל לבצע ספירה לאחור עד סיום הפעולה של החד יציב.

השלישי Decoder – תפקידו הוא לקבל את מוצא המונה הבינארי ולפרש אותו בכדי שהצג יוכל לתפקד כנדרש ולהוציא את הספרה שהוכנסה בכניסת המונה הבינארי.

אופן פעולה: המשתמש מבצע לחיצה וכך מתחילה מזיגה, באותו רגע שער ה-and מקבל "1" לוגי ובנוסף כניסות המונה הבינארי מקבלות אינדיקציה מאיזה ספירה להתחיל למנות לאחור. רכיב ה-decoder מקבל בכניסה את מוצא המונה הבינארי ומפרש במוצאו את הקוד הנדרש כדי להראות את הסיפרה על הצג. כאשר החד יציב מסיים את פעולתו כך שער and מקבל הפעם " 0" לוגי מה שגורם למונה הבינארי להתאפס ולחכות למנייה הבאה וכך חוזר חלילה.

איור :25 מעגל עבור שעון המערכת.

10 . תכנון מפורט ברמת החיבורים של LED אזהרה.


באיור מספר 26 נוכל להבחין במספר רכיבים אשר בעזרתם נוכל לבצע את פעולת לד האזהרה.

הראשון טרנזיסטור BJT – ניתן לשים לב כי לתוך הכוס הוכנסו שני חוטים אשר מטרתם להעביר מתח כאשר גובה המים מגיע אליהם.

אופן פעולה של הטרנזיסטור:

מדובר בטרנזיסטור NPN כידוע הטרנזיסטור נמצא במצב פעיל כאשר BV במצב אחורי ) V < V( ו BV במצב קידמי V > V.

וכאשר הטרנזיסטור נמצא במצב קיטעון כאשר BV במצב אחורי ) V < V( ו BV במצב אחורי (V < V).

כפי שניתן לראות מתח באופן קבוע: 0 = V , 5 = V . ניתן להבחין כאשר ההדק הבסיס אינו נוגע במים, מתח הבסיס הוא V0 לכן הטרנזיסטור נמצא במצב קיטעון והנורה אינה נדלקת כפי ההסבר שניתן. וכאשר הדק הבסיס נוגע במים, מתח הבסיס הוא לערך V3 )המתח שעובר דרך המים קטן ממתח הנכנס (, לכן הטרנזיסטור נמצא במצב פעיל )הולכה(, כתוצאה מכך נסגר מעגל בין ה-VCC לאדמה והנורה נדלקת .

השני LED – תפקידו לאותת למשתמש כי מתחילה זליגה של המים מהכוס.

איור :26 מעגל עבור LED אזהרה.

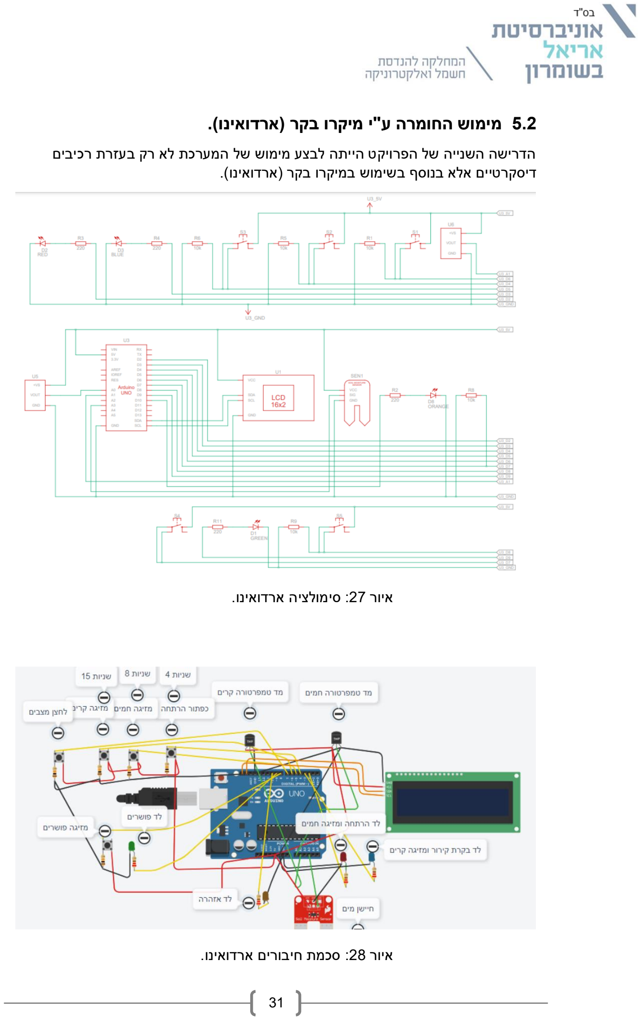
[picture p52: page 32]

5.2 מימוש החומרה ע"י מיקרו בקר )ארדואינו(.

הדרישה השנייה של הפרויקט הייתה לבצע מימוש של המערכת לא רק בעזרת רכיבים דיסקרטיים אלא בנוסף בשימוש במיקרו בקר )ארדואינו(.

איור :27 סימולציה ארדואינו.

איור :28 סכמת חיבורים ארדואינו.

באיורים 28,27 ניתן להבחין באופן חיבורו של הארדואינו, אחת מדרישות הפרויקט הייתה לבצע את כלל הפרויקט ברכיב זה, רכיב הארדואינו הינו בקר שבעזרתו ניתן לממש לא מעט מערכות בקרה .

אחת מהדרישות העיקריות היו לבצע מד טמפרטורה, מד טמפרטורה זה נעשה רק בעזרת הבקר "ארדואינו", וזאת בכדי לשקף למשתמש את טמפרטורת המים בזמן אמת בצורה הטובה ביותר.

ישנם מספר סיבות שבגללן נעשה המד טמפרטורה דרך הארדואינו ולא דרך רכיבים דיסקרטיים.

הראשונה החיישן – אחת הבעיות הגדלות שהיה נצרך להתמודד איתן במהלך הפרויקט היא החיישן, חיישן הטמפרטורה היה אינו לינארי, דבר זה מאוד הכביד על כל המערכת ובעקבות כך לאחר מספר דיונים בנושא הוחלט להציג את הטמפרטורה אך ורק דרך הארדואינו.

השנייה מתן מידע אמין – משום שהחיישן אינו לינארי, כמעט ולא הייתה אפשרות לתת למשתמש מידע אמין על טמפרטורת המים )הסטייה המתקבלת הייתה גדולה מאוד(.

השלישית צמצום רכיבים – המטריצה עצמה הייתה מאוד עמוסה ברכיבים, הוספת מד טמפרטורה היה דורש מאיתנו להוסיף מטריצה חדשה, בכדי שתהיה אפשרות לסיים את הפרויקט בזמן הנדרש.

באיור 27 ניתן להבחין בסימולציה של הארדואינו, סימולציה זו מבטאת את "המוח של המערכת" הכוונה היא שדרך סימולציה זו ניתן לדעת בצורה טובה מאילו רכיבים המערכת מורכבת ואת אופן פעולתה.

באיור 28 ניתן להבחין בסכמת החיבורים הכוונה היא לדרך שבה הרכיב מורכב בפועל, זאת אומרת איך הרכיב נראה בזמן אמת. בפועל כלל רכיבי הסימולציה נמצאים בתוך הארדואינו ואופן החיבור משקף את איך זה נראה במציאות.

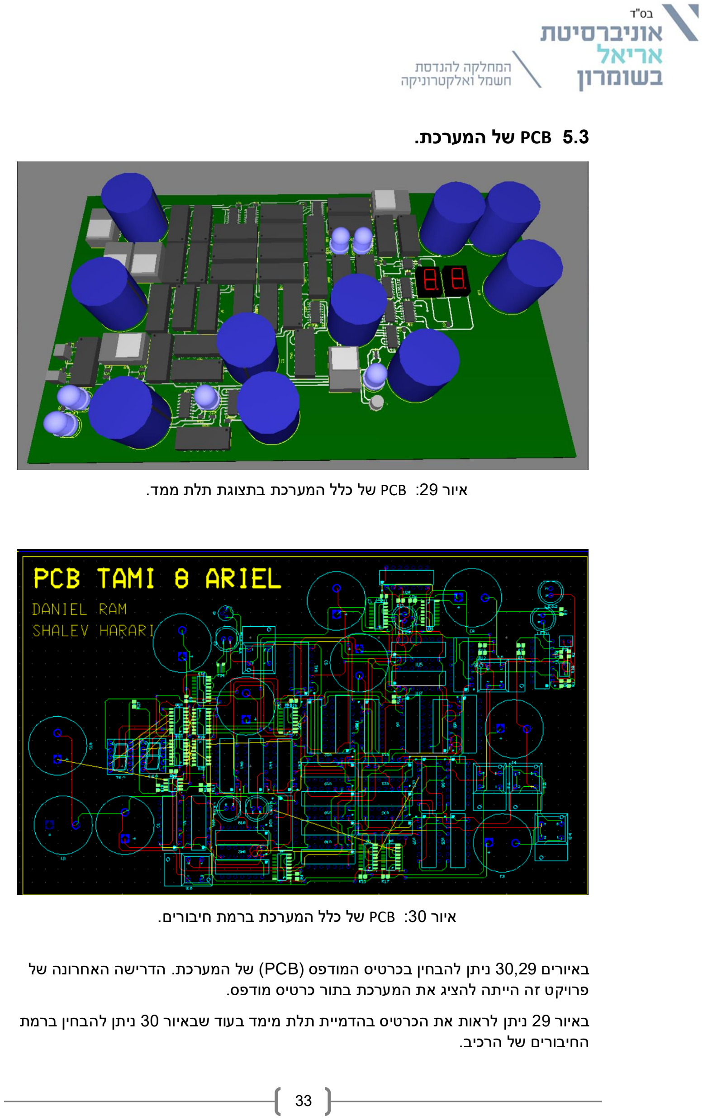
[picture p53: page 34]

5.3 PCB של המערכת.

באיורים 30,29 ניתן להבחין בכרטיס המודפס )PCB )של המערכת. הדרישה האחרונה של פרויקט זה הייתה להציג את המערכת בתור כרטיס מודפס.

באיור 29 ניתן לראות את הכרטיס בהדמיית תלת מימד בעוד שבאיור 30 ניתן להבחין ברמת החיבורים של הרכיב.

איור :29 PCB של כלל המערכת בתצוגת תלת ממד.

איור :30 PCB של כלל המערכת ברמת חיבורים.

6( תוצאות ואתגרים.

6.1 תוצאות הפרויקט.

בכדי להקל על ההבנה של כלל התוצאות חולק הכלל הפרויקט לארבעה חלקים עיקריים.

חלק א – מעגל מים חמים.

במעגל זה התקבל כי עבור מתן איתות של מים חמים מתחיל תהליך ההרתחה עד אשר המים מגיעים ל ,90° לאחר מכן התחילה פעולת המזיגה אשר אורכה היה es 4 , כפי שהיה ניתן לצפות. לאחר פעולת המזיגה היה ניתן להבחין כי טמפרטורת המים יורדת )כיוון שהגוף חימום הפסיק את פעולתו(, לאחר זמן מה ניתן לשים לב כי הגוף חימום מתחיל את פעולתו בשנית, דבר הקורה כתוצאה מפעולת הבקר )טמפרטורת המים ירדה מתחת ל 50°(, כפי שהיה ניתן לצפות.

חלק ב – מעגל מים קרים.

במעגל זה התקבל כי עבור מתן איתות של מזיגת מים קרים נדרש מהמשתמש להכניס מידע בשנית, בכדי לאותת למערכת מהו זמן המזיגה הרצוי. כצפוי היה ניתן להבחין כי עבור כל אחת מהאפשרויות )זמנים( המעגל תפקד כראוי כפי שהיה ניתן לצפות. בנוסף, אם טמפרטורת המים עלתה מעל 10° היה ניתן להבחין בשינוי – המערכת התחילה לאותת כי טמפרטורת המים עלתה וכתוצאה מכך נדרש להפעיל בשנית את גוף הקירור בכדי להביא את המים לטמפרטורה הרצויה, כפי שהיה ניתן לצפות מפעולת הבקר.

חלק ג – מים פושרים. ניתן היה לראות שהתקבל תוצאות מתאימות כפי הנדרש.

חלק ד – עצירה, תצוגה, מד טמפרטורה.

כל אחד מהפעולות הללו קשורים לכלל המעגל ים ולכן צוינו בנפרד.

עצירה- היה ניתן לשים לב כי בכל פעם שהמשתמש היה מעוניין להפסיק את פעולת המערכת מה שהיה נדרש ממנו זה לבצע לחיצה נוספת על אחד מכפתורי המערכת אשר בעזרתם ניתן לבצע עצירה של פעולת המזיגה.

תצוגה – כלל המעגלים חוברו לצג אשר בעזרתו ניתן להציג למשתמש מתי נגמרת פעולת המזיגה.

מד טמפרטורה- בעזרת רכיב הארדואינו ניתן להציג למשתמש בכל רגע נתון מהי טמפרטורת המים בזמן אמת .

6.2 שגיאות המערכת.

מים פושרים - ישנה אפשרות של שגיאה עד .5%

מד טמפרטורה - ישנה אפשרות של שגיאה עד .±3°

זמני המערכת - ישנה אפשרות של שגיאה עד es .±0.5

6.3 אתגרים במהלך הפרויקט.

במהלך הפרויקט נמצאו לא מעט קשיים אשר לקחו לא מעט זמן עד שנמצא להם פתרון, כמובן שנעשו שינויים בכדי להציג את הפרויקט בצורה הטובה ביותר.

הראשון בקר מים חמים – בתחילה מומש הבקר אך ורק בעזרת מגבר, הכוונה היא שלא היה סוג של עקומת חשל אלא היה רק מתח סף, זאת אומרת שהרכיב עצמו היה מאוד בזבזני. בתחילה הוחלט על מתח סף כלשהו )אשר התקבל ב 70°( ומאז הבקר התחיל להפעיל את פעולת החימום, הבעיה במצב זה שבכל פעם שהטמפרטורה רק עברה במעט את רף ה 70° , מערכת ההרתחה חדלה מלעבוד ולכן נשמר מים בטמפרטורה של 70° ולא 90° כפי שנדרש. בכדי לתקן בעיה זו מומש באמצעות מגבר בעל משוב חיובי המזכיר "שמיט טריגר" ובכך התקבל סוג של עקומת חשל אשר מפעילה את גוף החימום עד לטמפרטורה הרצויה.

השני, מים פושרים – בתחילה נעשו המון חישובים אך בכל פעם שהתקבלה תוצאה, בזמן אמת לא אומת הדרישה כנכונה. בכדי להתגבר על מכשול זה נעשו ניסויים וטעיות עד אשר התקבלו הזמנים הרלוונטי ים להצגת מים פושרים הרצויה )טבלה 2(.

השלישי, צג ספירה לאחור – בתחילה נעשה שימוש בסוג מסוים של מונה בינארי אשר הספירה שלו התחילה מ 15 ומטה ולא מ9 ומטה, בכדי להתגבר על בעיה זו נעשה חיפוש נרחב ברחבי האינטרנט עד אשר נמצא מונה אשר מתחיל את ספירתו מ 9 ומטה לכן נרכש במיוחד רכיב זה. הסיבה שנבחר להשתמש דווקא במונה זה ולא במונה שמוצג במעבדה היא בכדי לחסוך במספר הרכיבים.

הרביעי, עצירת המערכת – בתחילה עלו לא מעט רעיונות, הרעיון שנבחר הוא השוואה בין המוצא לכניסה של החדי יציב כאשר יש השוואה בניהם הדק הריסט של כלל החדי יציב מקבלים " 0" לוגי . אך אחרי החיבור נוצרה בעיה כבר בלחיצה הראשונה רגלי הריסט קיבלו "0" לוגי זאת כתוצאה מהשוואה של המוצא והכניסה כי הכניסה והמוצא מקבלים "1" לוגי באותו זמן. בכדי להתגבר על בעיה זו הוחלט לבצע השהייה של חצי שנייה בעזרת קבל ונגד במוצאים של החד יציב וכך ברגע הראשון אין השוואה בין המוצא לכניסה ורק בלחיצה השנייה של אחד בלחצני המערכת תהיה השוואה בין הכניסה למוצא וכך נגרם עצירה של המערכת.

החמישי, קבלים – בתחילה כלל החישובים של מעגלי החד יציב בוצעו בעזרת קבל של u1000 בכדי לפשט את חישוב הנגד, אך היו שתי בעיות עיקריות לרכיב זה, הראשונה – גודל הקבל, השנייה – סטיית הקבל. כאשר נעשה שימוש בקבלים בעל קיבוליות גדולה הרכיב עצמו היה מאוד מסיבי מבחינת גודל דבר שמאוד השפיע על מראה המטריצה )פגע באסטטיות של המערכת ובנוסף תפס המון מקום במטריצה(, בעיה נוספת הינה הסטייה מהערך הרצוי כאשר נעשה שימוש בקבל זה הייתה לו סטיה מאוד גדולה )בין 10 ל12 אחוז( דבר זה מאוד השפיע על זמן יציאת הפולס. בכדי להתגבר על קשיים אלו הופסק השימוש בקבל זה והתחיל השימוש בקבל בעל קיבוליות נמוכה יותר דבר שגרם לכך שהמטריצה תהיה יותר אסתטית ובנוסף סטיית הקיבוליות הייתה מזערית דבר ש פחות השפיע על זמן יציאת הפולס.

## 7( סיכום ומסקנות

7.1 סיכום.

בפרויקט זה תוכננה ומומשה מערכת חכמה אשר בעזרתה נוכל לתת מים נקיים וראויים לשתייה.
לשם כך, ראשית נלמדו ונותחו הדרישות והפרמטרים בהם המערכת צריכה לעמוד. מתוך כך תוכננה סכמת בלוקים ראשונית אשר באמצעותה תוכננה המערכת ברמת החיבורים והרכיבים.

לאחר תכנון סכמת בלוקים בוצע תכנון החומרה אשר נעשה בתכנון רכיבים וחיבורים בתוכנת סימולציה Multisim ובוצעו סימולציות לתקינות המעגל. לאחר מכן, בוצע מימוש על גבי מטריצת חיבורים ובוצעו בדיקות תקינות במעגלים. בנוסף, נעשה תכנון PCB המוכן להדפסה עבור מעגלים אלו. בנוסף, לטובת הצגת טמפרטורה נעשה שימוש במיקרו בקר )ארדואינו(.

במהלך כלל העבודה בפרויקט בוצעו תיעודיים למדידות ולקביעות שנעשו ובהתאם לכך בוצעו תיקונים לייעול המעגלים.

### 7.2 מסקנות הפרויקט

✓ ככל שיבוצע תכנון מפורט טרם המימוש, כך המימוש יהיה תקין ויעיל יותר.

✓ לעיתים, לייעול המעגל ניתן להחליף את החיישן שייתן פרמטר רצוי. לדוגמה

שייתן ערך התנגדות כפונקציה של הטמפרטורה ולא מתח.

✓ על המתכנן לקבוע ערכי נקודת עבודה בהתאם לדרישות הנצרכות.

✓ לביצוע מדידות אמינות ומדויקות יש לבצע את המדידות בתנאי סביבה זהים עד

כמה שניתן.

8( מקורות ספרותיים.

מצגת קורס מעגלים לינאריים – פרופ' משה עינת.

מצגת קורס מעגלים ספרתיים – פרופ' גדי גולן.

מצגת קורס מבוא להנדסת חשמל - פרופ' גדי גולן.

דפי נתונים לכלל הרכיבים.
