DanielRam62/Smart-Water-Dispenser-Project/arduino_implementation/arduino.png

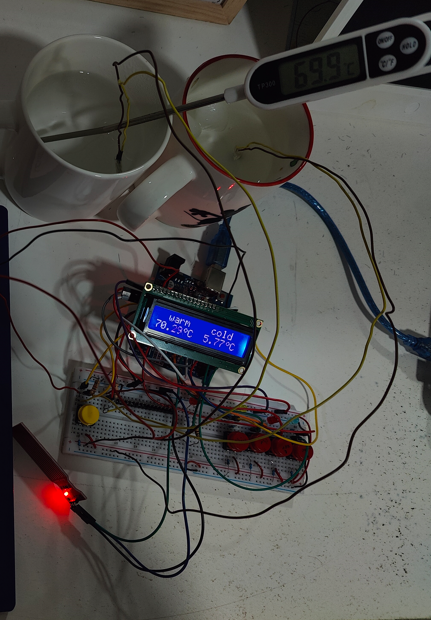
arduino_implementation/arduino.png
