DanielRam62/Smart-Water-Dispenser-Project/arduino_implementation/arduino_connections.png

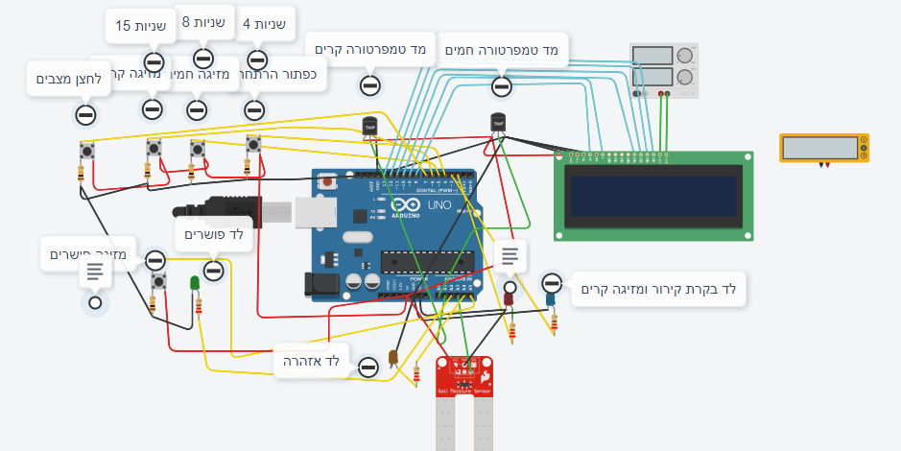
arduino_implementation/arduino_connections.png
