DanielRam62/Smart-Water-Dispenser-Project/arduino_implementation/arduino_schematics .png

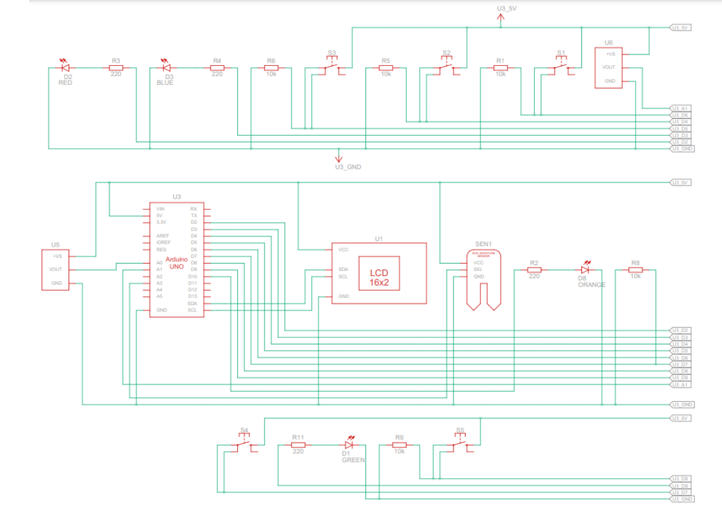
arduino_implementation/arduino_schematics .png
