DanielRam62/Smart-Water-Dispenser-Project/Photo of the system.jpg

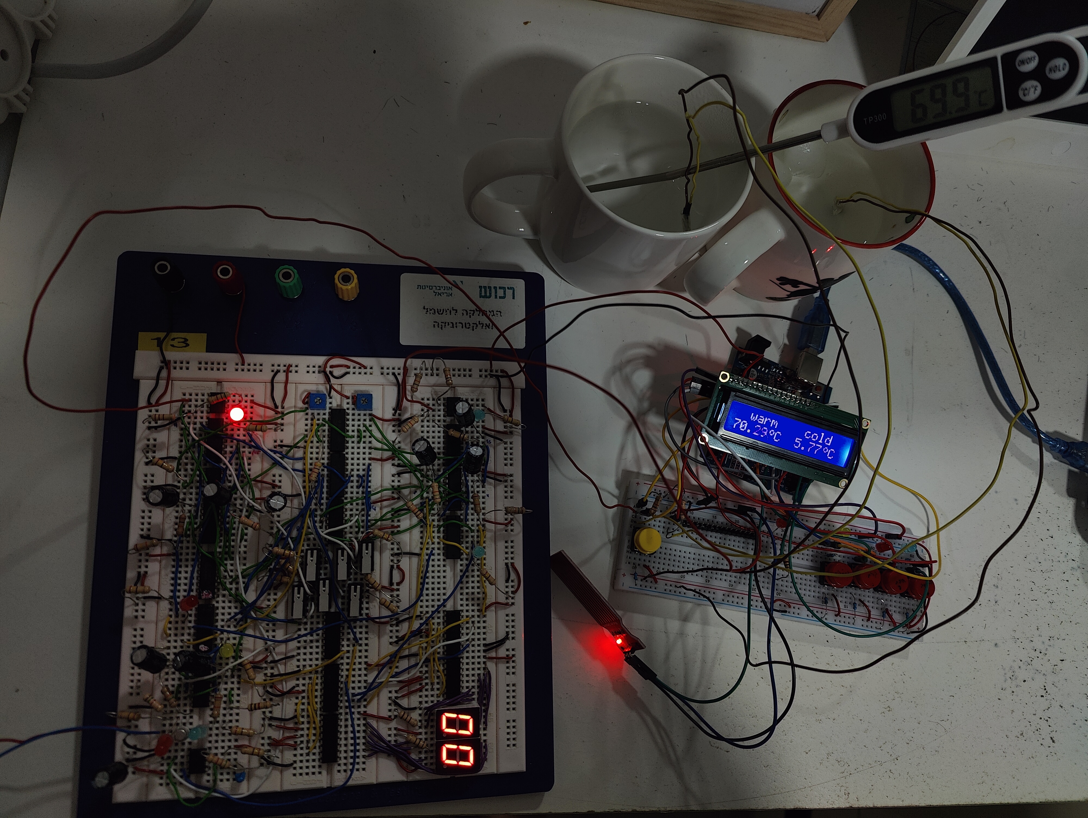
Photo of the system.jpg
