DanielRam62/Smart-Water-Dispenser-Project/(list of files, drawings)

Other design files:
hardware_implementation/schematics/circuit_design_multisim.ms14
